dchwebb/Hypersoniq/README.md

# Hypersoniq
 Eurorack Polyphonic High Pass Filter
