dchwebb/Hypersoniq/Graphics/Quilter_Panel.step

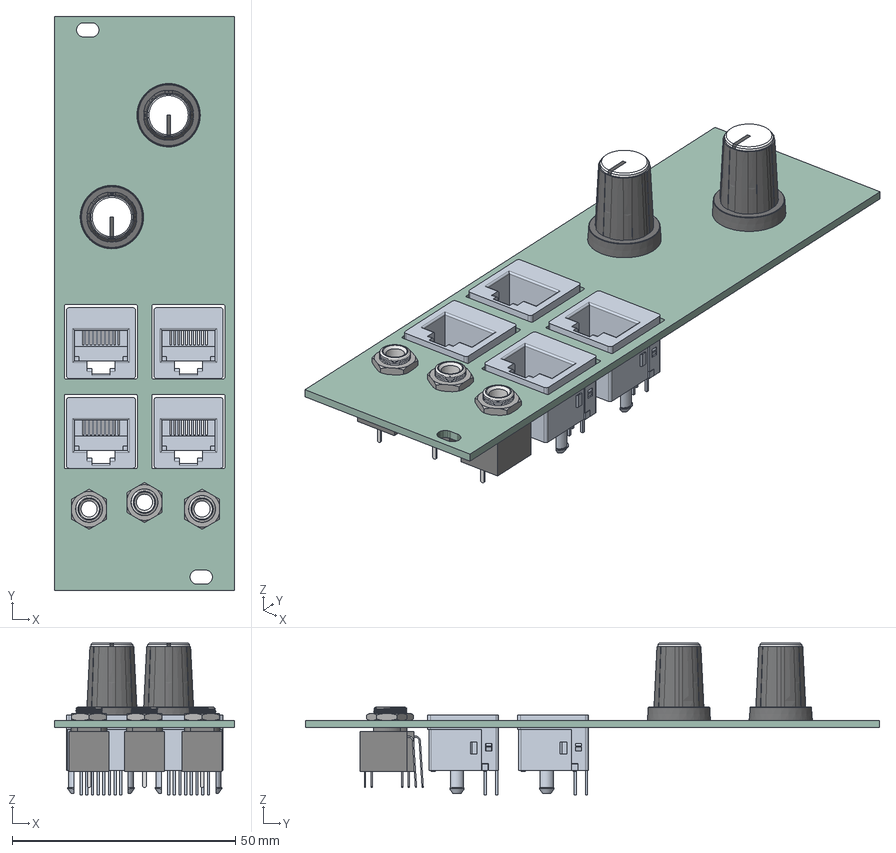
[picture p1: CAD file, 2023-07-27]
Graphics/Quilter_Panel.step
40.4 x 128.5 x 34.0 mm
Hypersoniq_Panel PCB
