dchwebb/Hypersoniq/Component_Mod.pdf

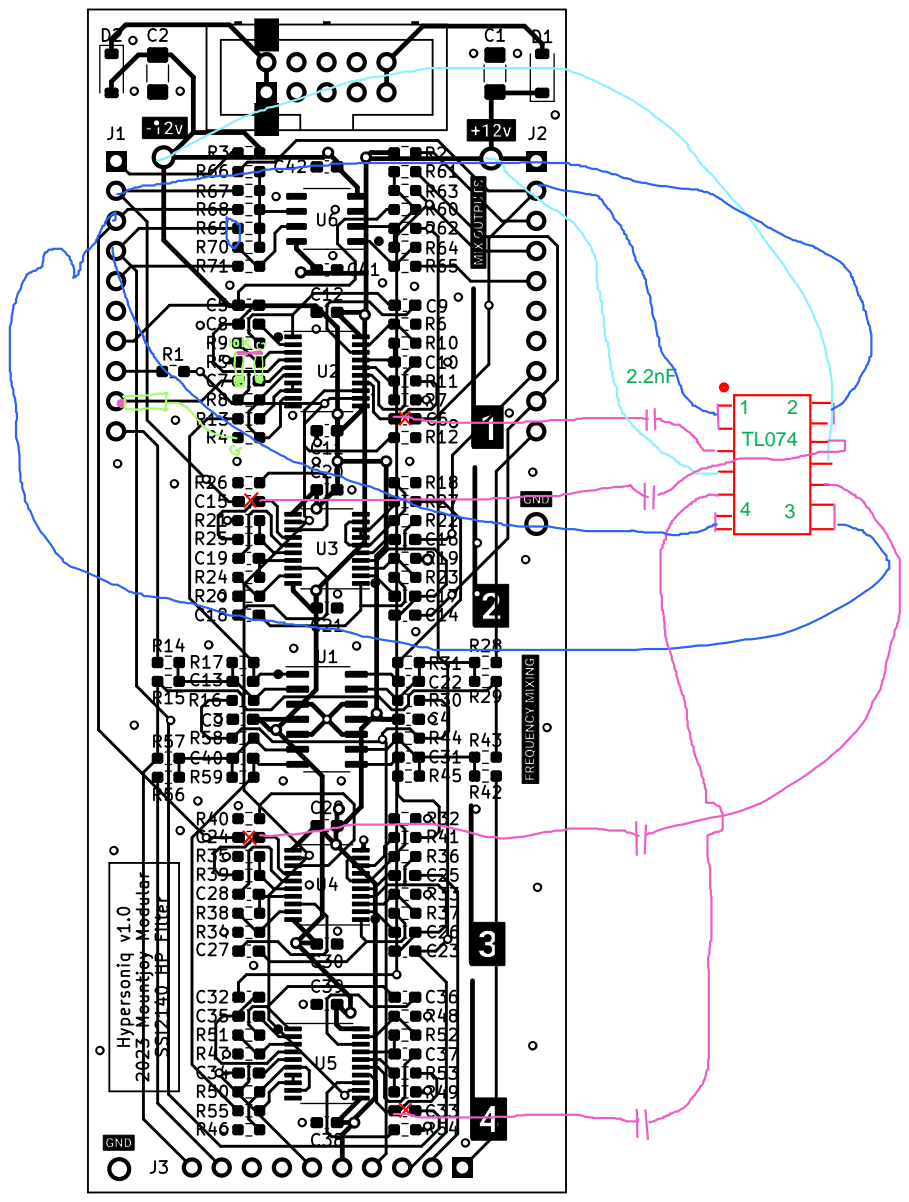
[picture p2: page 1]
