dchwebb/Hypersoniq/Hypersoniq_Controls.kicad_pcb

## KiCad design Hypersoniq_Controls.kicad_pcb (2023-07-27)

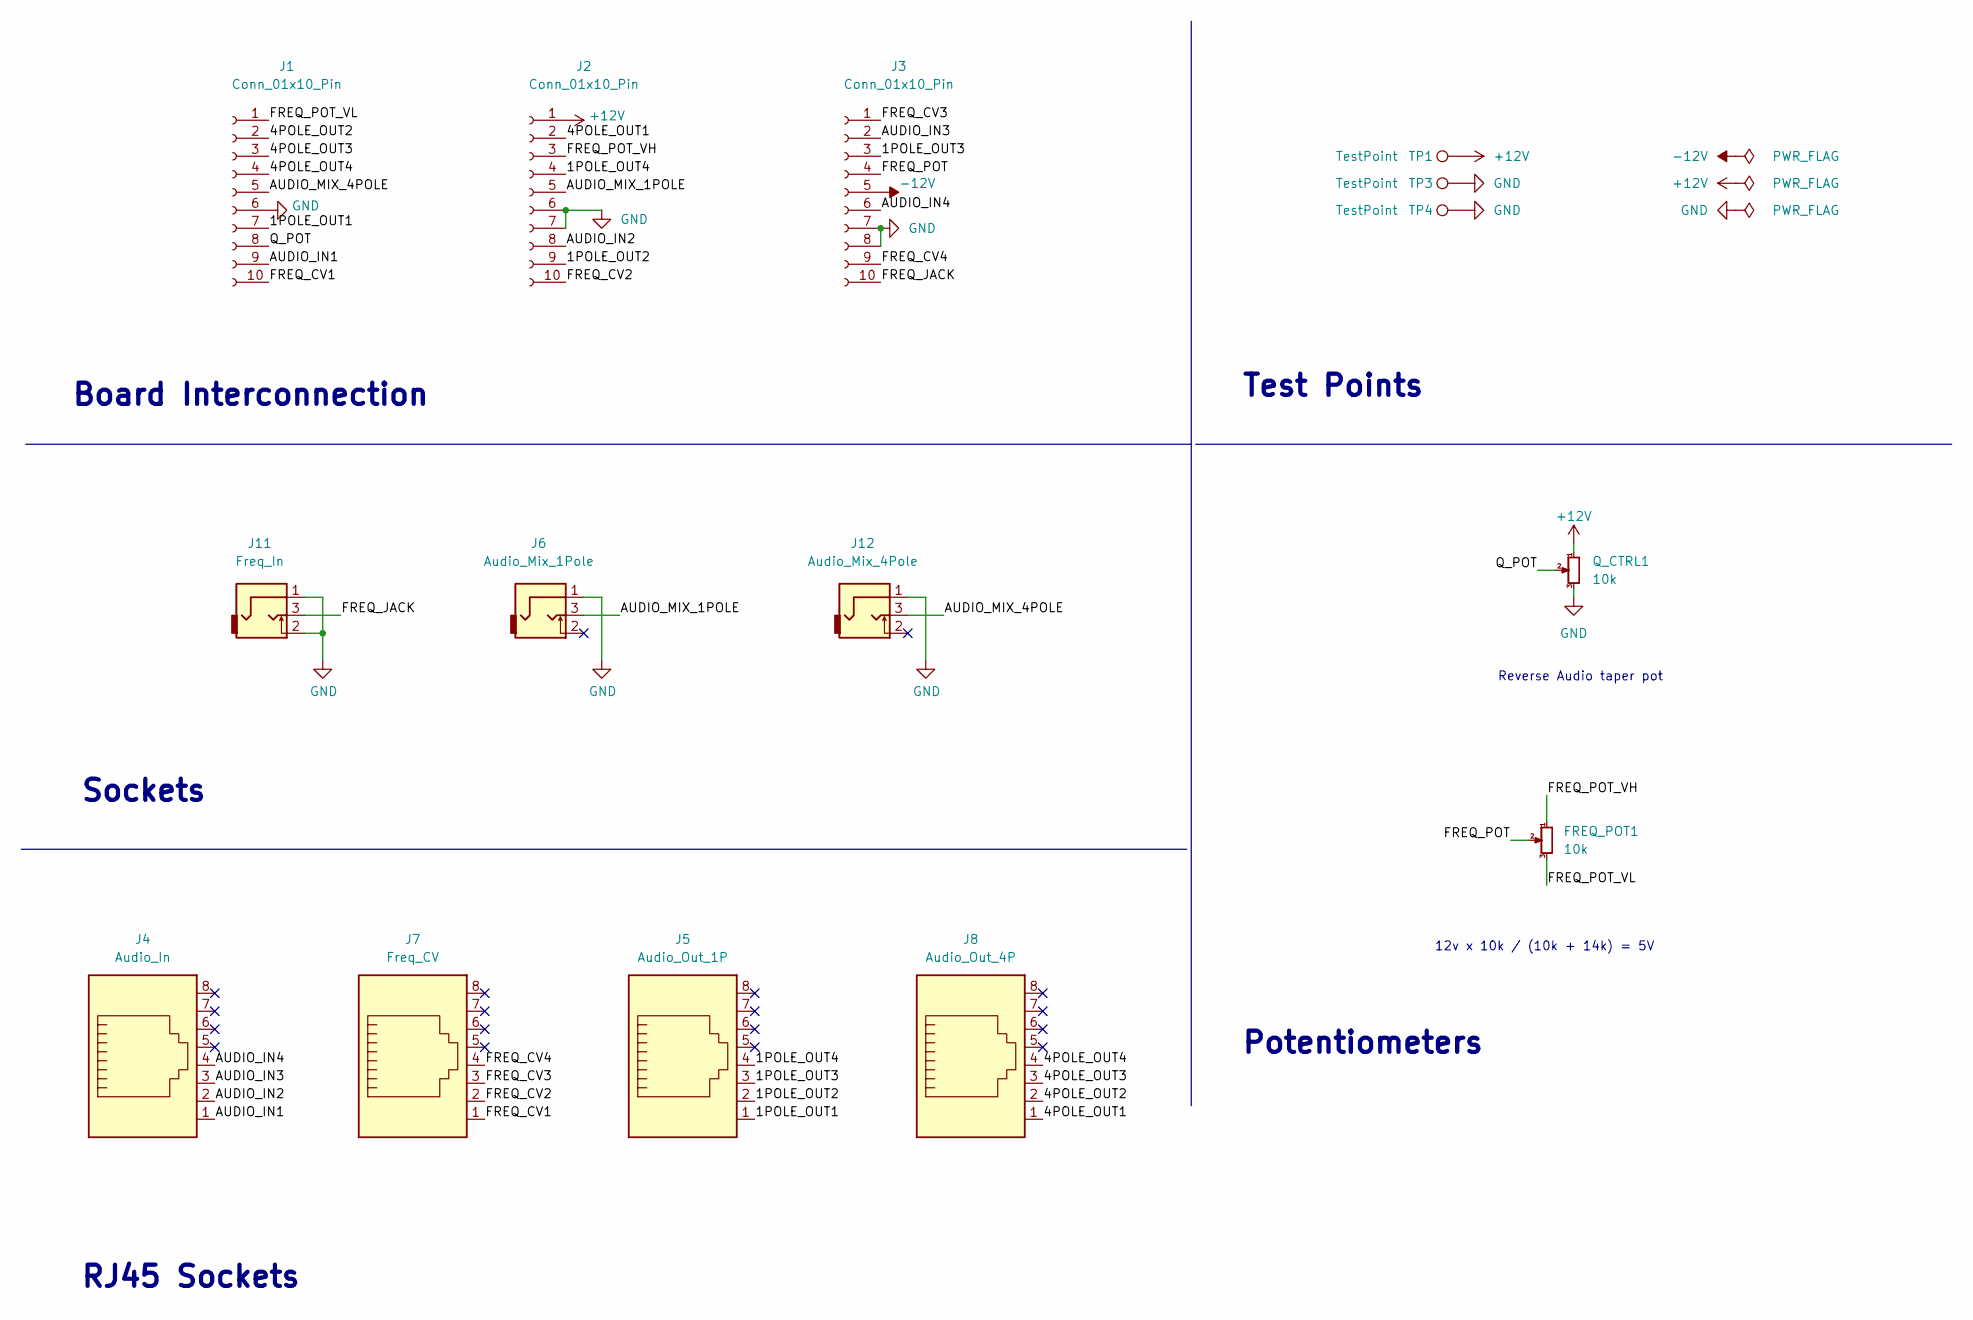
[picture p8: schematic Hypersoniq_Controls.kicad_sch, Quilter Controls]

Parts:
FREQ_POT1: 10k; Alpha_9mm_Potentiometer_Aligned
J1, J2, J3: Conn_01x10_Pin; PinSocket_1x10_P2.54mm_Vertical
J4: Audio_In; RJ45_Molex_42878-8506
J5: Audio_Out_1P; RJ45_Molex_42878-8506
J6: Audio_Mix_1Pole; THONKICONN_hole
J7: Freq_CV; RJ45_Molex_42878-8506
J8: Audio_Out_4P; RJ45_Molex_42878-8506
J11: Freq_In; THONKICONN_hole
J12: Audio_Mix_4Pole; THONKICONN_hole
Q_CTRL1: 10k; Alpha_9mm_Potentiometer_Aligned
TP1, TP3, TP4: TestPoint; 1.3mm_Test_Point

Connections:
+12V: J2.1, Q_CTRL1.1, TP1.1
-12V: J3.5
/1POLE_OUT1: J1.7, J5.1
/1POLE_OUT2: J2.9, J5.2
/1POLE_OUT3: J3.3, J5.3
/1POLE_OUT4: J2.4, J5.4
/4POLE_OUT1: J2.2, J8.1
/4POLE_OUT2: J1.2, J8.2
/4POLE_OUT3: J1.3, J8.3
/4POLE_OUT4: J1.4, J8.4
/AUDIO_IN1: J1.9, J4.1
/AUDIO_IN2: J2.8, J4.2
/AUDIO_IN3: J3.2, J4.3
/AUDIO_IN4: J3.6, J4.4
/AUDIO_MIX_1POLE: J2.5, J6.3
/AUDIO_MIX_4POLE: J1.5, J12.3
/FREQ_CV1: J1.10, J7.1
/FREQ_CV2: J2.10, J7.2
/FREQ_CV3: J3.1, J7.3
/FREQ_CV4: J3.9, J7.4
/FREQ_JACK: J3.10, J11.3
/FREQ_POT: FREQ_POT1.2, J3.4
/FREQ_POT_VH: FREQ_POT1.1, J2.3
/FREQ_POT_VL: FREQ_POT1.3, J1.1
/Q_POT: J1.8, Q_CTRL1.2
GND: J1.6, J2.6, J2.7, J3.7, J3.8, J6.1, J11.1, J11.2, J12.1, Q_CTRL1.3, TP3.1, TP4.1

Notes on the sheet:
RJ45 Sockets
Board Interconnection
Potentiometers
Sockets
Test Points
12v x 10k / (10k + 14k) = 5V
Reverse Audio taper pot

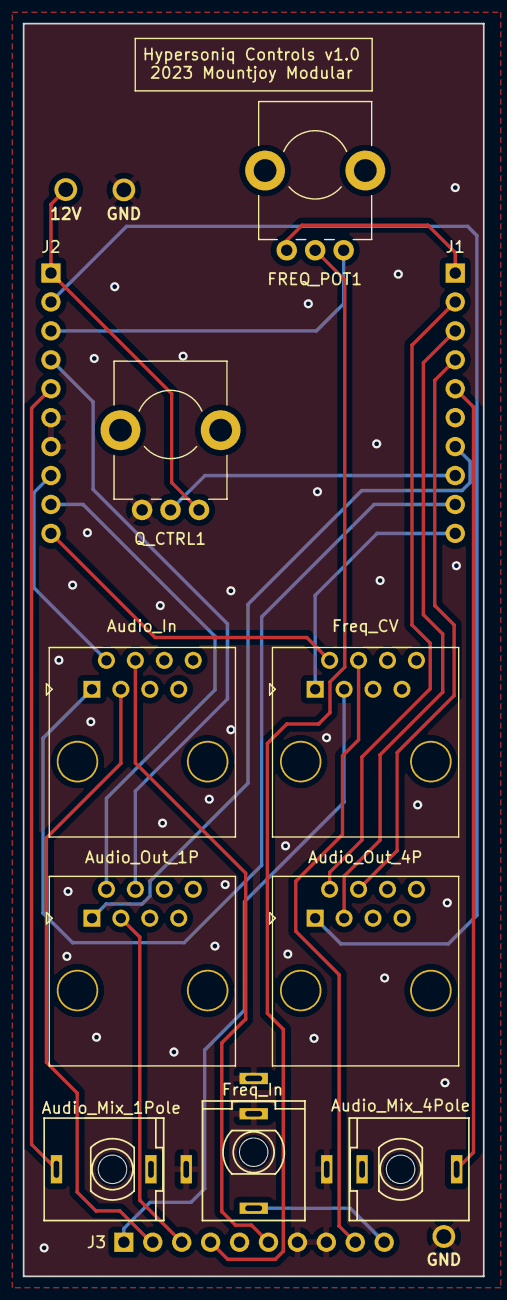
[picture p9: board Hypersoniq_Controls.kicad_pcb from above]

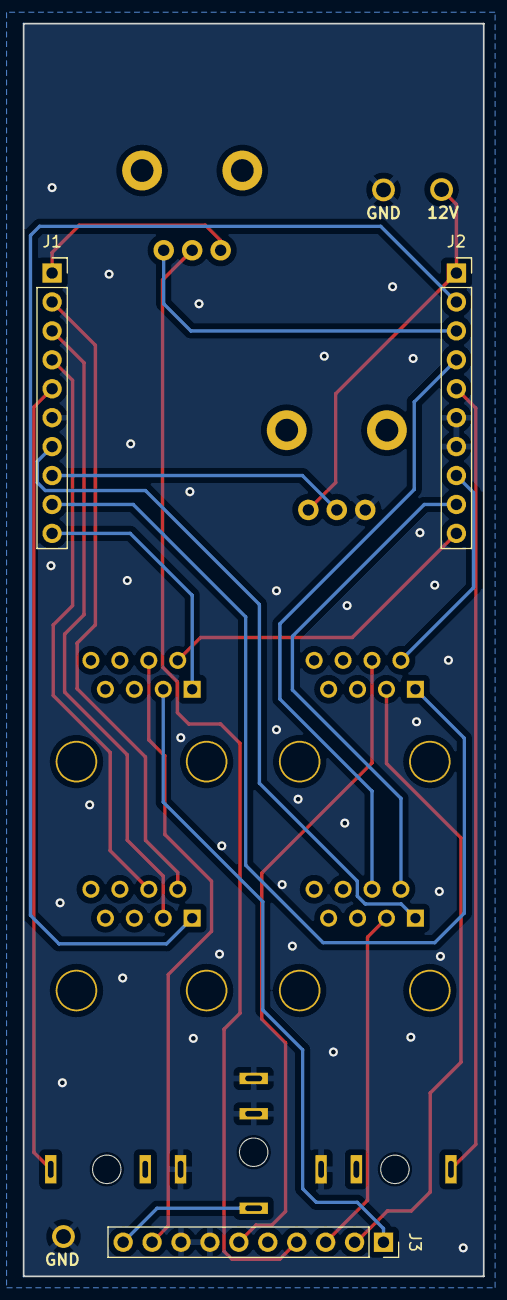
[picture p10: board Hypersoniq_Controls.kicad_pcb from below]

Board: 2 copper layers, 40.4 x 110.0 mm, 15 parts (3 on the bottom side), 25 nets.
