dchwebb/Hypersoniq/Hypersoniq_Components.kicad_pcb

## KiCad design Hypersoniq_Components.kicad_pcb (2023-07-27)

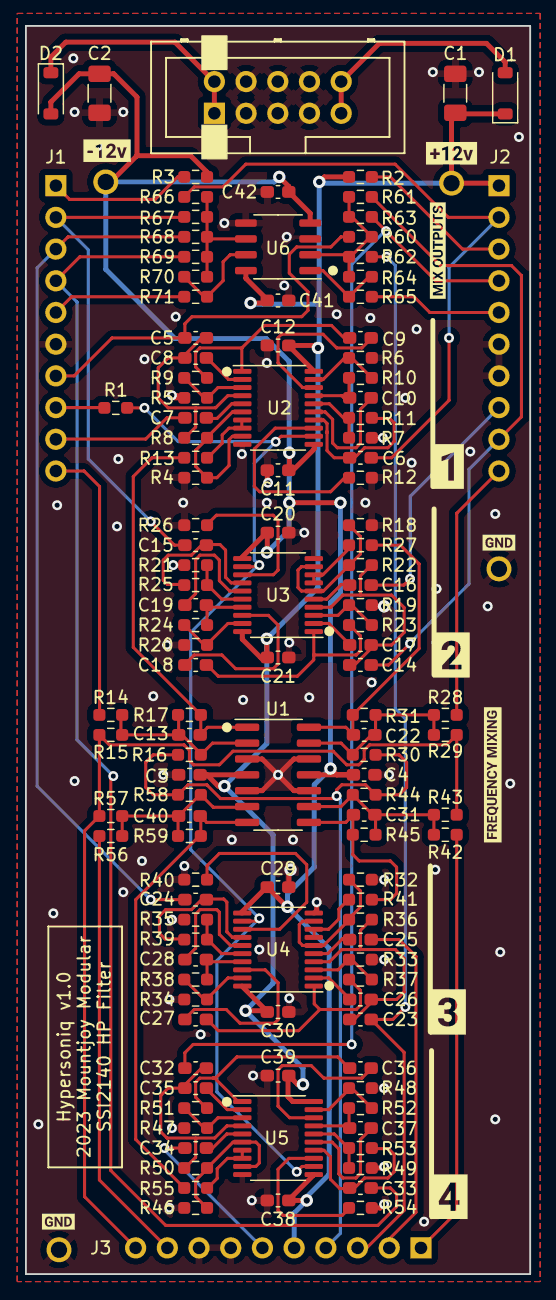
[picture p11: board Hypersoniq_Components.kicad_pcb from above]

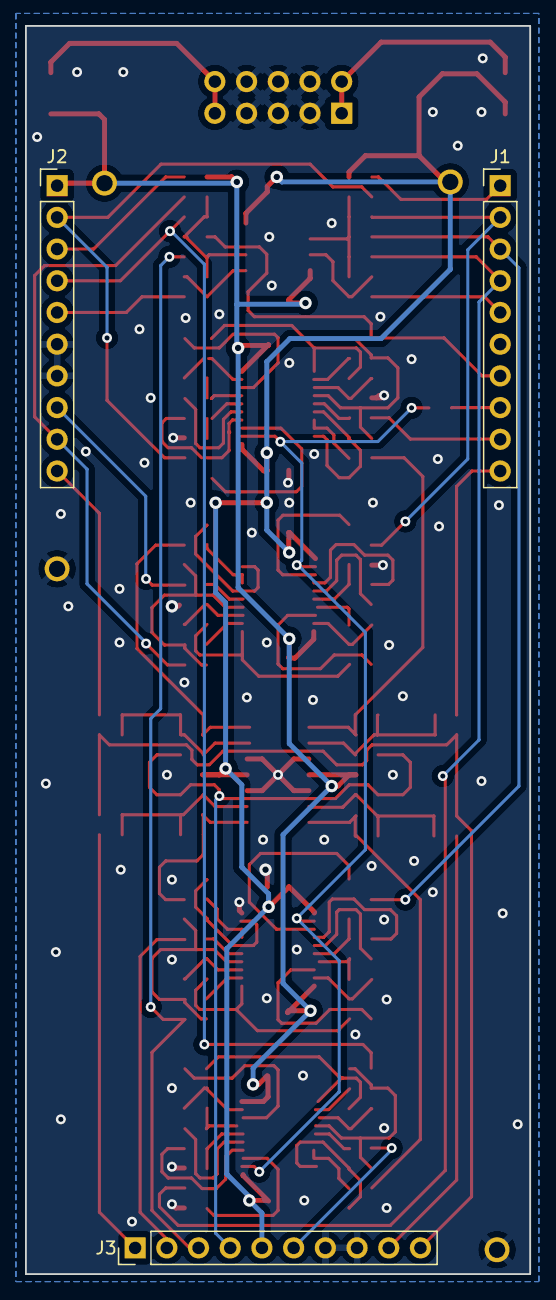
[picture p12: board Hypersoniq_Components.kicad_pcb from below]

Board: 2 copper layers, 40.4 x 100.0 mm, 139 parts (3 on the bottom side), 97 nets.

Parts:
C1, C2: 22uF; C_1206_3216Metric_Pad1.33x1.80mm_HandSolder
C3, C4, C11, C12, C20, C21, C29, C30, C38, C39, C41, C42: 100nF; C_0603_1608Metric_Pad1.08x0.95mm_HandSolder
C5, C6, C14, C15, C23, C24, C32, C33: 2.2nF; C_0603_1608Metric_Pad1.08x0.95mm_HandSolder
C7, C8, C9, C10, C16, C17, C18, C19, C25, C26, C27, C28, C34, C35, C36, C37: 1nF; C_0603_1608Metric_Pad1.08x0.95mm_HandSolder
C13, C22, C31, C40: 10nF; C_0603_1608Metric_Pad1.08x0.95mm_HandSolder
D1, D2: 1N5819; D_SOD-123
J1, J2, J3: Conn_01x10_Pin; PinHeader_1x10_P2.54mm_Vertical
J4: Eurorack_10_pin_power; Eurorack_10_pin_header
R1: 39k; R_0603_1608Metric_Pad0.98x0.95mm_HandSolder
R2: 8.2k; R_0603_1608Metric_Pad0.98x0.95mm_HandSolder
R3: 3.9k; R_0603_1608Metric_Pad0.98x0.95mm_HandSolder
R4, R5, R6, R7, R18, R19, R20, R21, R32, R33, R34, R35, R46, R47, R48, R49: 200; R_0603_1608Metric_Pad0.98x0.95mm_HandSolder
R8, R9, R10, R11, R22, R23, R24, R25, R36, R37, R38, R39, R50, R51, R52, R53, R60, R61, R62, R63, R66, R67, R68, R69: 10k; R_0603_1608Metric_Pad0.98x0.95mm_HandSolder
R12, R26, R40, R54, R65, R71: 1k; R_0603_1608Metric_Pad0.98x0.95mm_HandSolder
R13, R27, R41, R55: 56k; R_0603_1608Metric_Pad0.98x0.95mm_HandSolder
R14, R15, R16, R28, R29, R30, R42, R43, R44, R56, R57, R58: 100k; R_0603_1608Metric_Pad0.98x0.95mm_HandSolder
R17, R31, R45, R59: 150k; R_0603_1608Metric_Pad0.98x0.95mm_HandSolder
R64, R70: 4.7k; R_0603_1608Metric_Pad0.98x0.95mm_HandSolder
TP1, TP2, TP3, TP4: TestPoint; 1.3mm_Test_Point
U1: TL074; SOIC-14_3.9x8.7mm_P1.27mm
U2, U3, U4, U5: SSI2140; TSSOP-20_4.4x6.5mm_P0.65mm
U6: TL072; SO-8_3.9x4.9mm_P1.27mm
kibuzzard-64BBE4CA: G***; kibuzzard-64BBE4CA
kibuzzard-64BBF5E4: G***; kibuzzard-64BBF5E4
kibuzzard-64BBF56E: G***; kibuzzard-64BBF56E
kibuzzard-64BBF60A: G***; kibuzzard-64BBF60A
kibuzzard-64BBF567: G***; kibuzzard-64BBF567
kibuzzard-64BBF574: G***; kibuzzard-64BBF574
kibuzzard-64BBF597: G***; kibuzzard-64BBF597
kibuzzard-64BE60E0: G***; kibuzzard-64BE60E0
kibuzzard-640237DF, kibuzzard-640237DF#2: G***; kibuzzard-640237DF

Connections:
+12V: C1.1, C3.1, C12.1, C21.1, C30.1, C39.1, C41.1, D1.1 (K), J2.1, R2.1, TP1.1, U1.4 (V+), U2.20 (V+), U3.20 (V+), U4.20 (V+), U5.20 (V+), U6.8 (V+)
-12V: C2.2, C4.1, C11.1, C20.1, C29.1, C38.1, C42.1, D2.2 (A), J3.5, R3.2, TP2.1, U1.11 (V-), U2.11 (V-), U3.11 (V-), U4.11 (V-), U5.11 (V-), U6.4 (V-)
/1POLE_OUT1: C5.2, J1.7, R60.2
/1POLE_OUT2: C14.2, J2.9, R61.2
/1POLE_OUT3: C23.2, J3.3, R62.2
/1POLE_OUT4: C32.2, J2.4, R63.2
/4POLE_OUT1: C6.1, J2.2, R66.2
/4POLE_OUT2: C15.1, J1.2, R67.2
/4POLE_OUT3: C24.1, J1.3, R68.2
/4POLE_OUT4: C33.1, J1.4, R69.2
/+12V_IN: D1.2 (A), J4.9, J4.10
/-12V_IN: D2.1 (K), J4.1, J4.2
/AUDIO_IN1: C7.1, J1.9
/AUDIO_IN2: C16.1, J2.8
/AUDIO_IN3: C25.1, J3.2
/AUDIO_IN4: C34.1, J3.6
/AUDIO_MIX_1POLE: J2.5, R65.2
/AUDIO_MIX_4POLE: J1.5, R71.2
/FREQ_CV1: J1.10, R14.2
/FREQ_CV2: J2.10, R28.2
/FREQ_CV3: J3.1, R42.2
/FREQ_CV4: J3.9, R56.2
/FREQ_JACK: J3.10, R15.2, R29.2, R43.2, R57.2
/FREQ_POT: J3.4, R16.2, R30.2, R44.2, R58.2
/FREQ_POT_VH: J2.3, R2.2
/FREQ_POT_VL: J1.1, R3.1
/Filter_Voice1/FREQ_CONTROL: C13.2, R13.2, R17.1, U1.1
/Filter_Voice1/Q_FEEDBACK: R4.1, R8.2, U2.6, U2.9
/Filter_Voice2/FREQ_CONTROL: C22.2, R27.2, R31.1, U1.14
/Filter_Voice2/Q_FEEDBACK: R18.1, R22.2, U3.6, U3.9
/Filter_Voice3/FREQ_CONTROL: C31.2, R41.2, R45.1, U1.8
/Filter_Voice3/Q_FEEDBACK: R32.1, R36.2, U4.6, U4.9
/Filter_Voice4/FREQ_CONTROL: C40.2, R55.2, R59.1, U1.7
/Filter_Voice4/Q_FEEDBACK: R46.1, R50.2, U5.6, U5.9
/Q_CONTROL: R1.2, U2.12, U3.12, U4.12, U5.12
/Q_POT: J1.8, R1.1
GND: C1.2, C2.1, C3.2, C4.2, C11.2, C12.2, C20.2, C21.2, C29.2, C30.2, C38.2, C39.2, C41.2, C42.2, J1.6, J2.6, J2.7, J3.7, J3.8, J4.3, J4.4, J4.5, J4.6, J4.7, J4.8, R4.2, R5.2, R6.2, R7.2, R12.2, R18.2, R19.2, R20.2, R21.2, R26.2, R32.2, R33.2, R34.2, R35.2, R40.2, R46.2, R47.2, R48.2, R49.2, R54.2, TP3.1, TP4.1, U1.3 (+), U1.5 (+), U1.10 (+), U1.12 (+), U2.10 (GND), U3.10 (GND), U4.10 (GND), U5.10 (GND), U6.3 (+), U6.5 (+)
unnamed: C5.1, C8.1, R8.1, U2.4
unnamed: C6.2, R11.1, U2.14
unnamed: C7.2, U2.5
unnamed: C8.2, U2.2
unnamed: C9.1, R9.1, U2.1
unnamed: C9.2, U2.18
unnamed: C10.1, R10.1, U2.17
unnamed: C10.2, U2.15
unnamed: C14.1, C17.1, R22.1, U3.4
unnamed: C15.2, R25.1, U3.14
unnamed: C16.2, U3.5
unnamed: C17.2, U3.2
unnamed: C18.1, R23.1, U3.1
unnamed: C18.2, U3.18
unnamed: C19.1, R24.1, U3.17
unnamed: C19.2, U3.15
unnamed: C23.1, C26.1, R36.1, U4.4
unnamed: C24.2, R39.1, U4.14
unnamed: C25.2, U4.5
unnamed: C26.2, U4.2
unnamed: C27.1, R37.1, U4.1
unnamed: C27.2, U4.18
unnamed: C28.1, R38.1, U4.17
unnamed: C28.2, U4.15
unnamed: C32.1, C35.1, R50.1, U5.4
unnamed: C33.2, R53.1, U5.14
unnamed: C34.2, U5.5
unnamed: C35.2, U5.2
unnamed: C36.1, R51.1, U5.1
unnamed: C36.2, U5.18
unnamed: C37.1, R52.1, U5.17
unnamed: C37.2, U5.15
unnamed: R5.1, R9.2, U2.3
unnamed: R6.1, R10.2, U2.19
unnamed: R7.1, R11.2, U2.16
unnamed: R12.1, U2.13
unnamed: R19.1, R23.2, U3.3
unnamed: R20.1, R24.2, U3.19
unnamed: R21.1, R25.2, U3.16
unnamed: R26.1, U3.13
unnamed: R33.1, R37.2, U4.3
unnamed: R34.1, R38.2, U4.19
unnamed: R35.1, R39.2, U4.16
unnamed: R40.1, U4.13
unnamed: R47.1, R51.2, U5.3
unnamed: R48.1, R52.2, U5.19
unnamed: R49.1, R53.2, U5.16
unnamed: R54.1, U5.13
unnamed: R64.1, R65.1, U6.1
unnamed: R70.1, R71.1, U6.7
unnamed: C13.1, R14.1, R15.1, R16.1, R17.2, U1.2 (-)
unnamed: C40.1, R56.1, R57.1, R58.1, R59.2, U1.6 (-)
unnamed: C31.1, R42.1, R43.1, R44.1, R45.2, U1.9 (-)
unnamed: C22.1, R28.1, R29.1, R30.1, R31.2, U1.13 (-)
unnamed: R13.1, U2.7 (EXPO_CTL), U2.8 (TEMPCO)
unnamed: R27.1, U3.7 (EXPO_CTL), U3.8 (TEMPCO)
unnamed: R41.1, U4.7 (EXPO_CTL), U4.8 (TEMPCO)
unnamed: R55.1, U5.7 (EXPO_CTL), U5.8 (TEMPCO)
unnamed: R60.1, R61.1, R62.1, R63.1, R64.2, U6.2 (-)
unnamed: R66.1, R67.1, R68.1, R69.1, R70.2, U6.6 (-)
