dchwebb/Hypersoniq/(commit log)

2023-07-19 First draft of schematic
    [Filter_Voice.kicad_sch, Hypersoniq.kicad_pcb, Hypersoniq.kicad_sch]
2023-07-22 PCB Layout
    [Filter_Voice.kicad_sch, Hypersoniq.kicad_pcb, Hypersoniq.kicad_sch]
2023-07-22 Revert "PCB Layout"
    This reverts commit f9e64c4088f3b37948fb3949196b7229d7a48ca0.
    [Filter_Voice.kicad_sch, Hypersoniq.kicad_pcb, Hypersoniq.kicad_sch]
2023-07-22 Revert "Revert "PCB Layout""
    This reverts commit 17ea893c43406ccb0184a474adf0eed468bf1595.
    [Filter_Voice.kicad_sch, Hypersoniq.kicad_pcb, Hypersoniq.kicad_sch]
2023-07-22 First draft of PCB layout complete
    [Hypersoniq.kicad_pcb]
2023-07-23 Controls PCB lay out
    [Filter_Voice.kicad_sch, Hypersoniq.kicad_pcb, Hypersoniq_Controls.kicad_pcb, Hypersoniq_Controls.kicad_sch]
2023-07-23 Started laying out Panel
    [Hypersoniq_Components.kicad_pcb, Hypersoniq_Components.kicad_sch, Hypersoniq_Controls.kicad_pcb, Hypersoniq_Panel.kicad_pcb]
2023-07-24 Started generating JLC placement details
    [BOM-Hypersoniq_Components.csv, Filter_Voice.kicad_sch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]
2023-07-24 Minor cleanup
    [Hypersoniq_Components.kicad_pcb, Hypersoniq_Controls.kicad_pcb]
2023-07-25 Panel and Control tidy up
    [Hypersoniq_Controls.kicad_pcb, Hypersoniq_Panel.kicad_pcb]
2023-07-25 Updated SSI2149 symbol; cleaned up routing on component board
    [Filter_Voice.kicad_sch, Hypersoniq_Components.kicad_pcb]
2023-07-26 Updated SSI2140 footprints
    [Hypersoniq_Components.kicad_pcb]
2023-07-27 v1.0 Design sent for manufacture
    [BOM-Hypersoniq_Components.csv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]
2023-08-12 Added v1.0 component schematic pdf
    [Filter_Voice.kicad_sch, Hypersoniq_Components.kicad_sch]
2023-09-14 Minor changes
    [Filter_Voice.kicad_sch, Hypersoniq_Components.kicad_sch]
